yctatli/ro-to-bottle/docs/img/arduino-buzzer.png

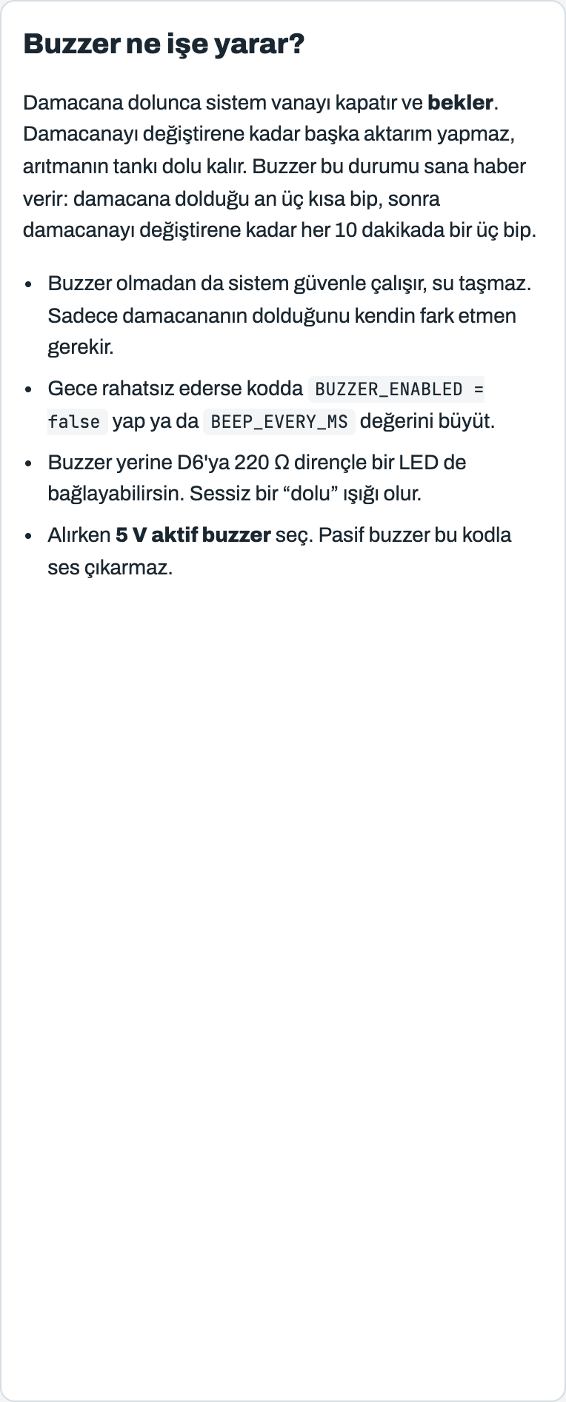
docs/img/arduino-buzzer.png
