yctatli/ro-to-bottle/docs/img/maliyet-priz.png

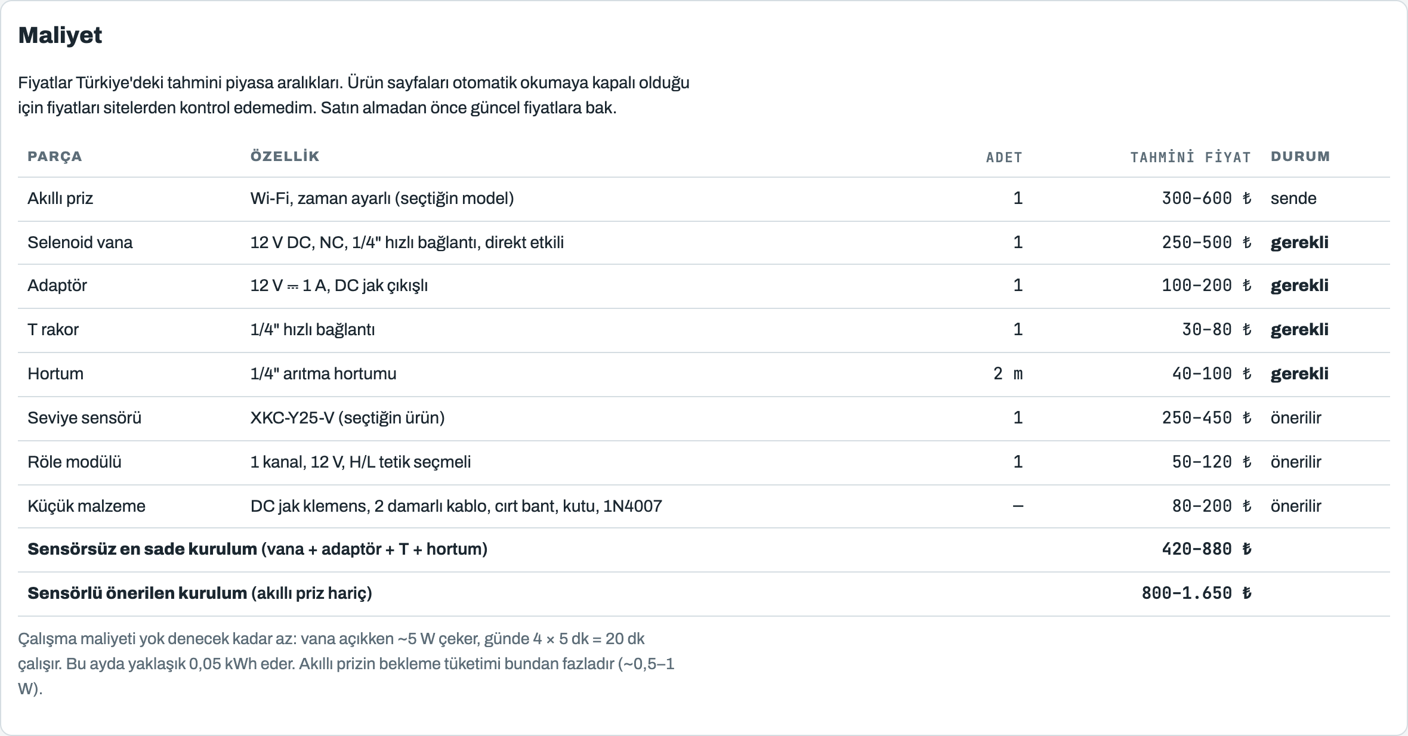
docs/img/maliyet-priz.png
